cotty52/Mouse/Documents/nrf-documents/nRF52840-QFAA Reference Layout 1_0/Bill of Materials/nrf52840_qfaa_bom.xls

Bill of material
Device: | nRF52840-QFAA
Title: | Reference Layout
Version: | 1.0
Designator | Value | Description | Assembly | Footprint Doc
C1, C2, C16, C17 | 12pF | Capacitor, NP0, ±2% |  | 0201
C3 | 1.0pF | Capacitor, NP0, ±10% |  | 0201
C4 | 1.2pF | Capacitor, NP0, ±10% |  | 0201
C5, C6, C7, C8, C12 | 100nF | Capacitor, X5R, ±10% |  | 0201
C10 | N.C. | Not mounted | Not mounted | 0201
C11 | 100pF | Capacitor, NP0, ±5% |  | 0201
C13, C14 | 1.0µF | Capacitor, X5R, ±10% |  | 0402
C15 | 47nF | Capacitor, X5R, ±10% |  | 0201
L1 | 4.7nH | High frequency chip inductor ±5% |  | 0201
L2 | 2.2nH | High frequency chip inductor ±5% |  | 0201
L3 | 10µH | Chip inductor, IDC,min = 50 mA, ±20% |  | 0603
L4 | 15nH | High frequency chip inductor ±10% |  | 0402
U1 | nRF52840-QFAA | Multi-protocol Bluetooth Low Energy, IEEE 802.15.4, ANT and 2.4GHz proprietary system-on-chip |  | QFN-48
X1 | 32MHz | XTAL SMD 2016, 32MHz, Cl=8pF, Total Tol: ±30ppm |  | XTAL_2016
X2 | 32.768kHz | XTAL SMD 2012, 32.768kHz, Cl=9pF, Total Tol: ±50ppm |  | XTAL_2012
