cotty52/Mouse/KiCad/bom/Mouse_Project-BOM-2026-01-19.xlsx

 | Sourced | Placed | References | Value | Footprint | Quantity
1 | TRUE | FALSE | C1, C6, C9, C11 | 10uF | CL31A106KBHNNNE | 4
2 | TRUE | FALSE | C3, C4, C5, C8 | 0.1uF | C1206C104K5RACTU | 4
3 | TRUE | FALSE | C2, C7 | 4.7uF | CL31B475KBHNNNE | 2
4 | TRUE | FALSE | C10 | 120pF | C0805C121J5GACTU | 1
5 | TRUE | FALSE | R1 | 10k | RC1206FR-0710KL | 1
6 | TRUE | TRUE | R2 | 13 | RC0805N_YAG | 1
7 | TRUE | TRUE | R5 | 330k | RES_CRGCQ1206F330K_TEC | 1
8 | TRUE | FALSE | L1 | 470nH | DFE252012P-1R0M=P2 | 1
9 | TRUE | TRUE | U1 | TPS62821DLCR | TPS62821DLCR | 1
10 | TRUE | FALSE | U2 | TTC_Gold_Encoder | TTC_Gold_Encoder | 1
11 | TRUE | FALSE | SW1 | Power | SW_1218_EWI | 1
12 | TRUE | FALSE | SW2 | Signal | SW_1218_EWI | 1
13 | TRUE | FALSE | SW3 | Scroll_Button | SW4_1825910-B_TEC | 1
14 | TRUE | FALSE | SW4 | DPI_Button | SW4_1825910-B_TEC | 1
15 | TRUE | FALSE | Kailh_Switch1 | Left | Kailh_Switch | 1
16 | TRUE | FALSE | Kailh_Switch2 | Right | Kailh_Switch | 1
17 | TRUE | FALSE | Kailh_Switch3 | Thumb1 | Kailh_Switch | 1
18 | TRUE | FALSE | Kailh_Switch4 | Thumb2 | Kailh_Switch | 1
19 | TRUE | FALSE | NRF52840_ProMicro1 | nrf52840 | nrf52840_promicro | 1
20 | TRUE | FALSE | PMW3389DM-T3QU1 | pmw3389 | pmw3389dm-t3qu | 1
21 | TRUE | FALSE | J1 | B2B-PH-K-S | CONN2_B2B-PH-K-S_JST | 1
