cotty52/Mouse/Documents/nrf-Dongle.3mf

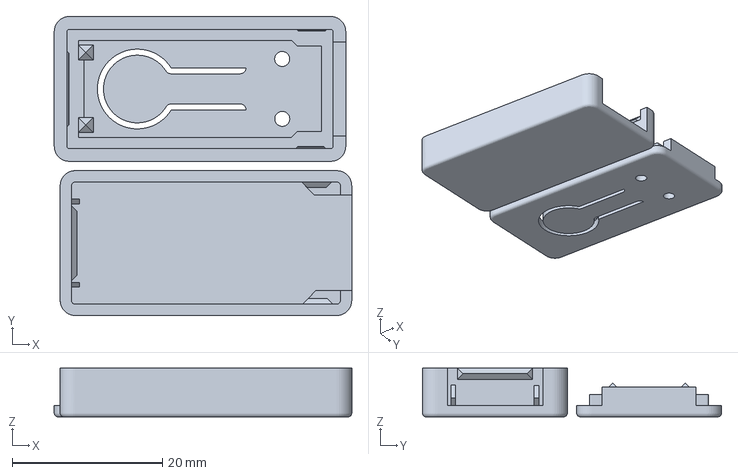
[picture p1: CAD file, 2026-04-07]
Documents/nrf-Dongle.3mf
39.5 x 39.7 x 6.50 mm
