cotty52/Mouse/KiCad/Mouse_Project_Libraries/GRM022R71A121KA01L.step

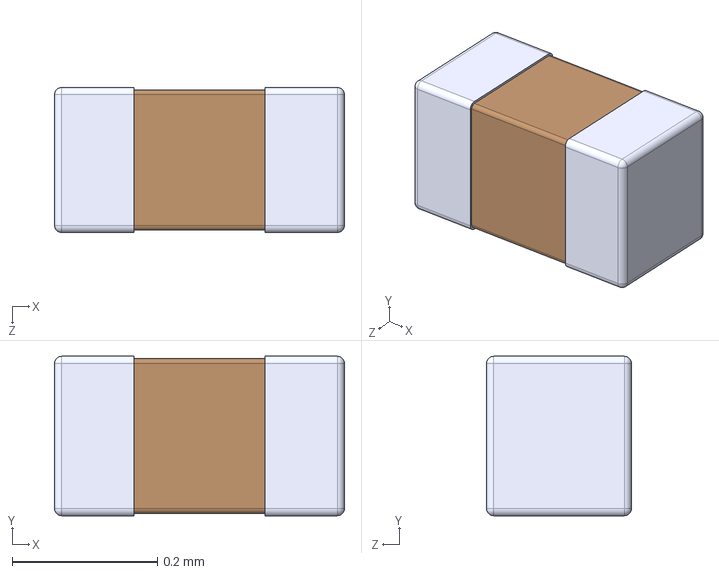
[picture p2: CAD file, 2025-11-20]
KiCad/Mouse_Project_Libraries/GRM022R71A121KA01L.step
0.4 x 0.22 x 0.2 mm
