cotty52/Mouse/KiCad/Mouse_Project_Libraries/CL31A106KBHNNNE.step

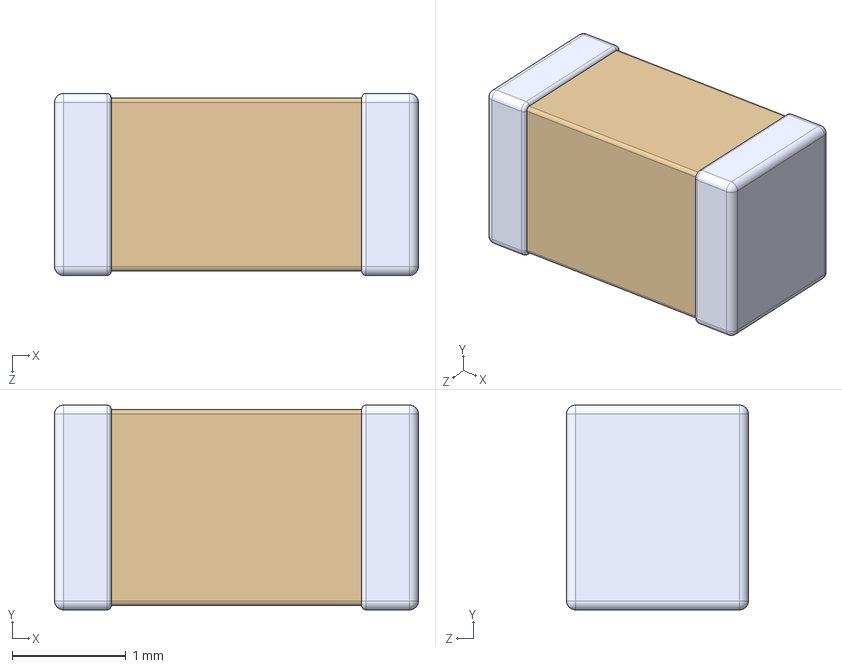
[picture p3: CAD file, 2025-11-20]
KiCad/Mouse_Project_Libraries/CL31A106KBHNNNE.step
3.20 x 1.80 x 1.60 mm
