cotty52/Mouse/KiCad/Mouse_Project_Libraries/C1206C104K5RACTU.step

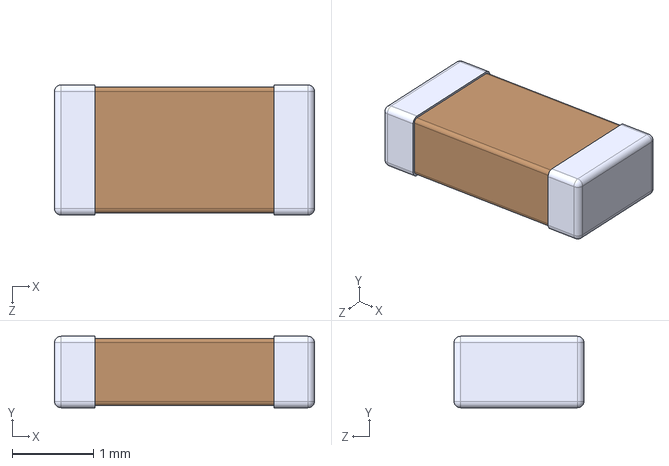
[picture p4: CAD file, 2025-11-20]
KiCad/Mouse_Project_Libraries/C1206C104K5RACTU.step
3.20 x 0.88 x 1.60 mm
