cotty52/Mouse/KiCad/Mouse_Project_Libraries/C0805C121J5GACTU.STEP

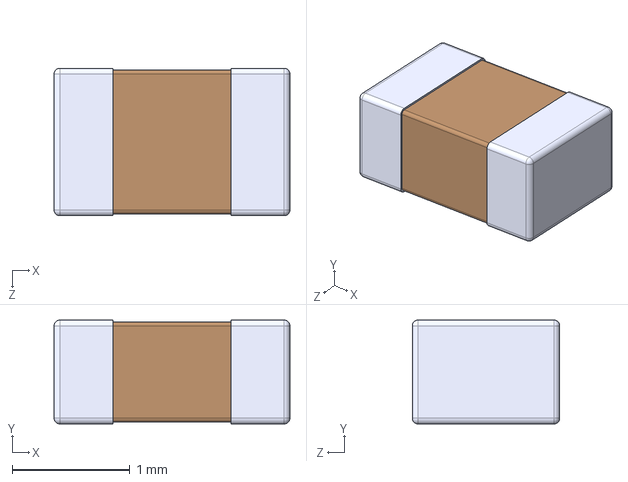
[picture p5: CAD file, 2025-11-20]
KiCad/Mouse_Project_Libraries/C0805C121J5GACTU.STEP
2.00 x 0.88 x 1.25 mm
