cotty52/Mouse/KiCad/Mouse_Project_Libraries/RC1206FR-0710KL.step

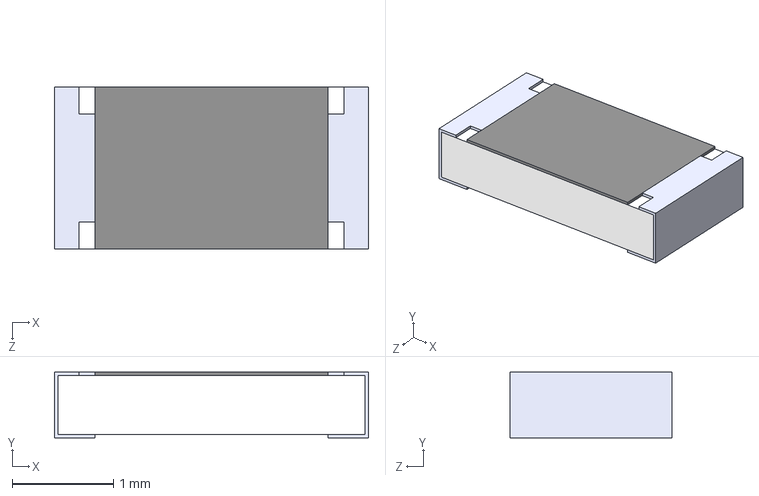
[picture p6: CAD file, 2025-11-20]
KiCad/Mouse_Project_Libraries/RC1206FR-0710KL.step
3.10 x 0.65 x 1.60 mm
