cotty52/Mouse/KiCad/Mouse_Project_Libraries/CRGCQ1206F330K.step

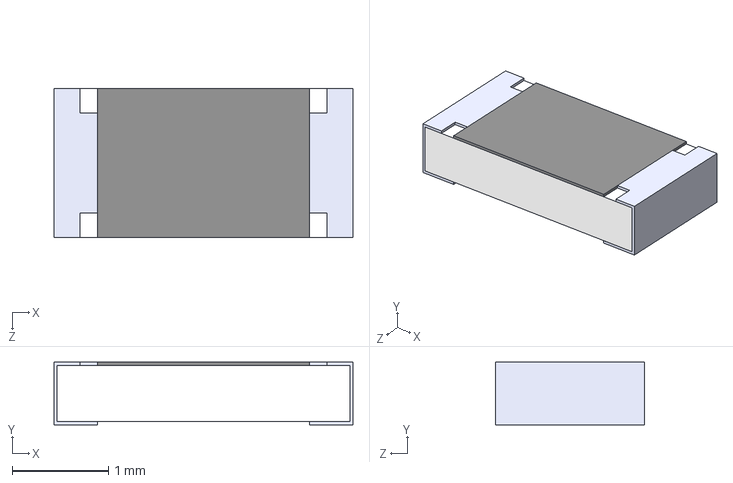
[picture p7: CAD file, 2025-03-05]
KiCad/Mouse_Project_Libraries/CRGCQ1206F330K.step
3.10 x 0.65 x 1.55 mm
