cotty52/Mouse/KiCad/Mouse_Project_Libraries/RC0402FR-07100KL.step

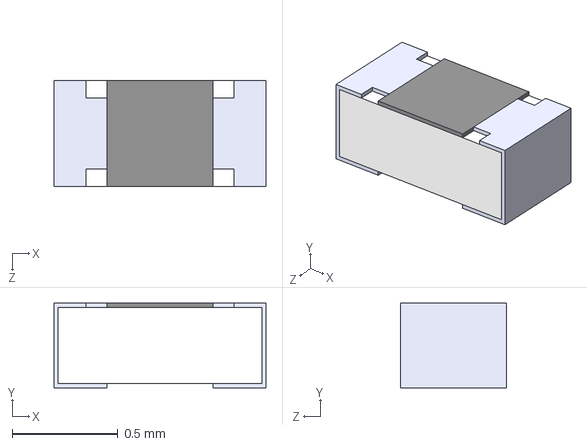
[picture p8: CAD file, 2025-03-01]
KiCad/Mouse_Project_Libraries/RC0402FR-07100KL.step
1 x 0.4 x 0.5 mm
