cotty52/Mouse/KiCad/Mouse_Project_Libraries/RES_CIGT201610.step

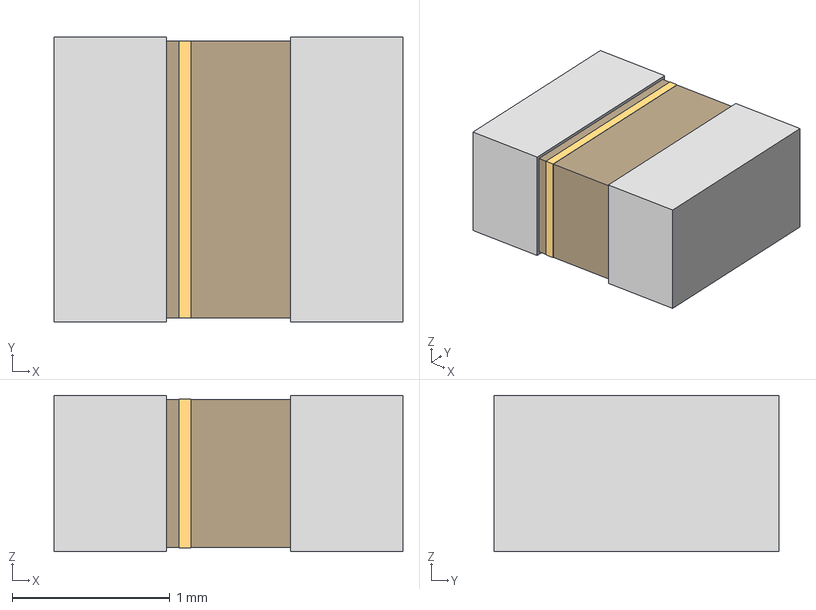
[picture p9: CAD file, 2025-03-01]
KiCad/Mouse_Project_Libraries/RES_CIGT201610.step
2.21 x 1.80 x 0.991 mm
