cotty52/Mouse/KiCad/Mouse_Project_Libraries/CL10B104KB8NNNC.step

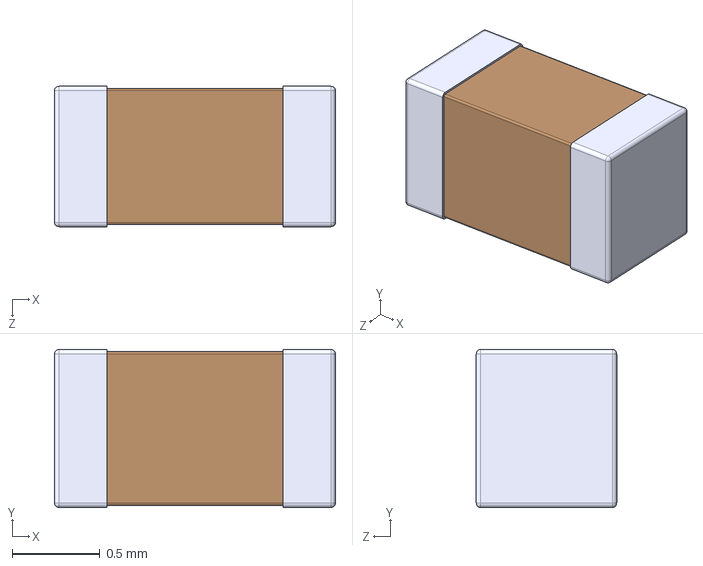
[picture p10: CAD file, 2025-03-01]
KiCad/Mouse_Project_Libraries/CL10B104KB8NNNC.step
1.60 x 0.9 x 0.8 mm
