cotty52/Mouse/KiCad/Mouse_Project_Libraries/RMCF0603FT220K.step

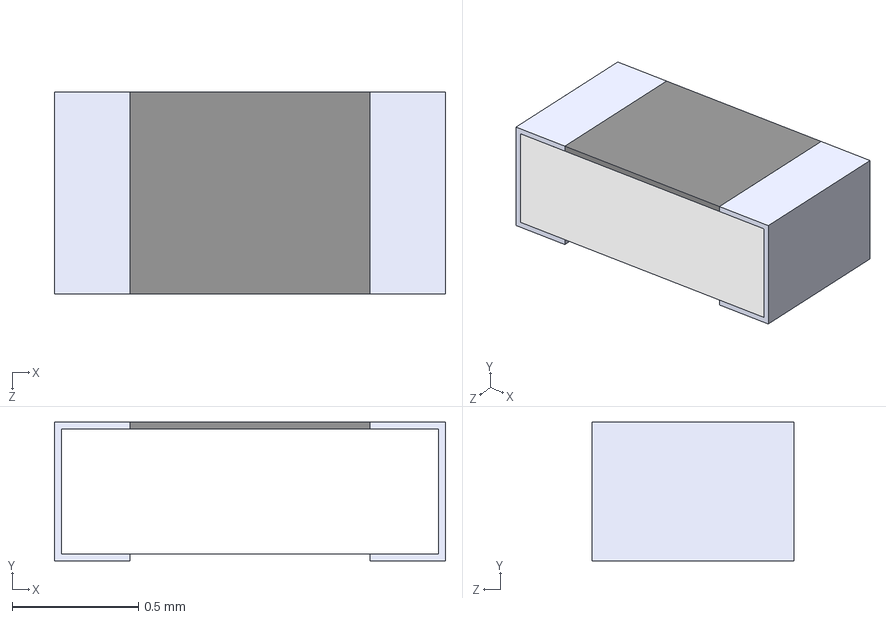
[picture p11: CAD file, 2025-03-01]
KiCad/Mouse_Project_Libraries/RMCF0603FT220K.step
1.55 x 0.55 x 0.8 mm
