cotty52/Mouse/KiCad/Mouse_Project_Libraries/GRM0335C1H121JA01D.step

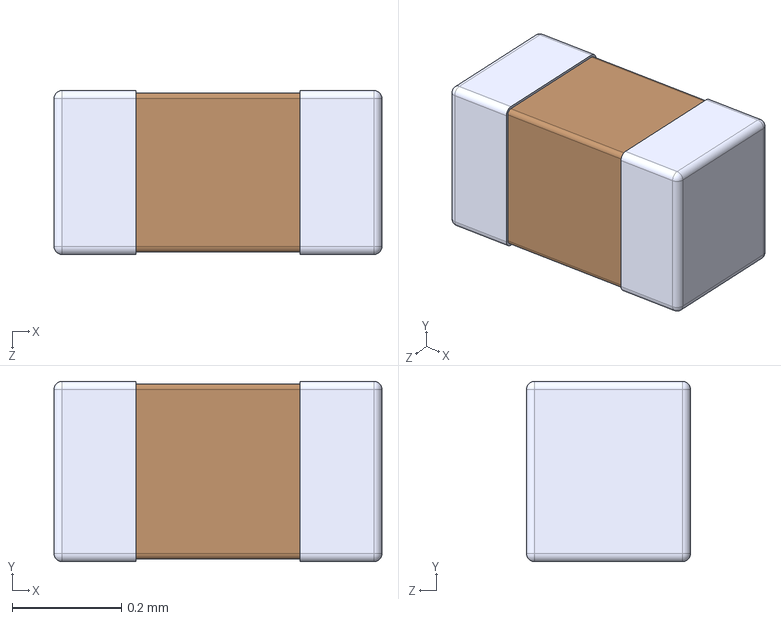
[picture p12: CAD file, 2025-03-01]
KiCad/Mouse_Project_Libraries/GRM0335C1H121JA01D.step
0.6 x 0.33 x 0.3 mm
