cotty52/Mouse/KiCad/Mouse_Project_Libraries/CL21A106KOQNNNE.step

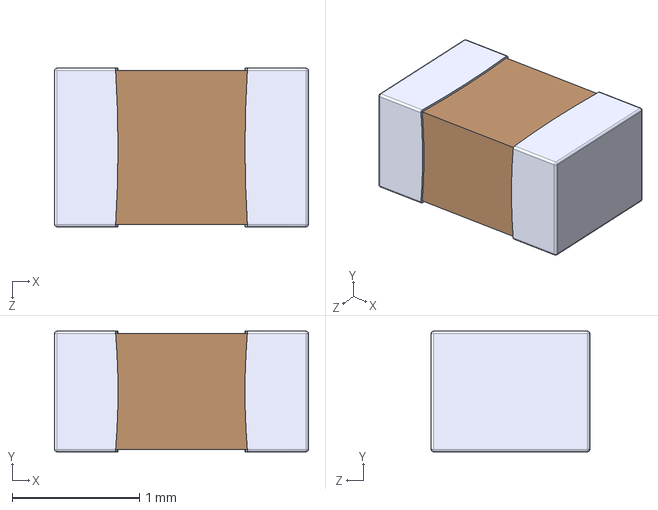
[picture p13: CAD file, 2025-03-01]
KiCad/Mouse_Project_Libraries/CL21A106KOQNNNE.step
2.00 x 0.95 x 1.25 mm
