cotty52/Mouse/KiCad/Mouse_Project_Libraries/RC0805FR-0713RL.step

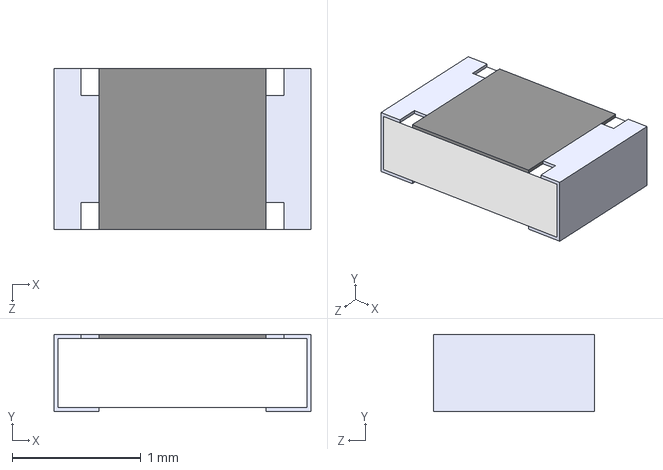
[picture p14: CAD file, 2025-03-01]
KiCad/Mouse_Project_Libraries/RC0805FR-0713RL.step
2.00 x 0.6 x 1.25 mm
