cotty52/Mouse/KiCad/Mouse_Project_Libraries/EG1218.stp

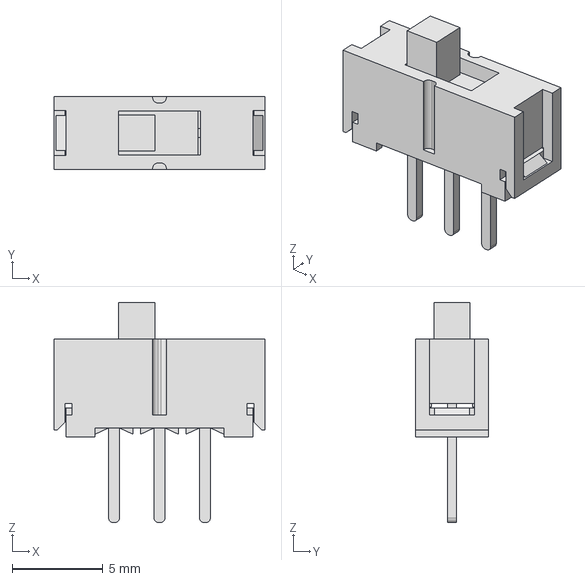
[picture p15: CAD file, 2025-03-01]
KiCad/Mouse_Project_Libraries/EG1218.stp
11.6 x 4.00 x 12.1 mm
