cotty52/Mouse/KiCad/Mouse_Project_Libraries/CL-SB-13B-01T.stp

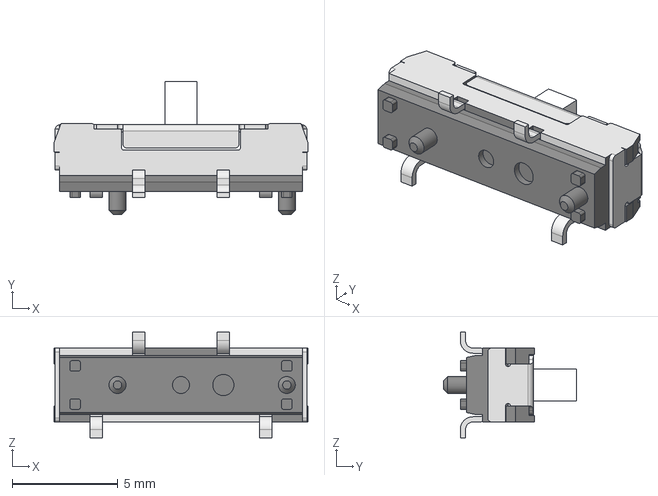
[picture p16: CAD file, 2025-03-01]
KiCad/Mouse_Project_Libraries/CL-SB-13B-01T.stp
12.0 x 6.30 x 5.00 mm
13B-01_c
3Top setting_s
