cotty52/Mouse/KiCad/Mouse_Project_Libraries/B2B-PH-K-S.step

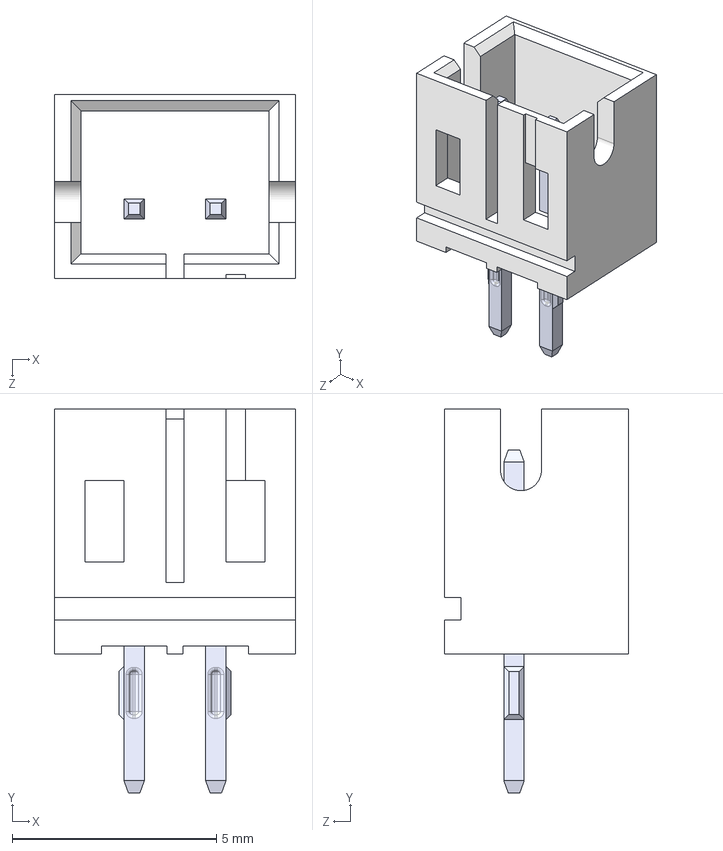
[picture p17: CAD file, 2025-02-25]
KiCad/Mouse_Project_Libraries/B2B-PH-K-S.step
5.90 x 9.40 x 4.50 mm
