cotty52/Mouse/(list of files, cad)

Other CAD files:
KiCad/Mouse_Project_Libraries/1825910-6.step
KiCad/Mouse_Project_Libraries/DFE252012P-R47M_P2.step
KiCad/Mouse_Project_Libraries/TPS62821DLCR.step
KiCad/Mouse_Project_Libraries/nrf52840.stp
