cotty52/Mouse/(list of files, drawings)

Other design files:
Documents/nrf-documents/nRF52840-QFAA Reference Layout 1_0/Altium Designer files/nrf52840_qfaa.PcbDoc
Documents/nrf-documents/nRF52840-QFAA Reference Layout 1_0/Altium Designer files/nrf52840_qfaa.PrjPCB
Documents/nrf-documents/nRF52840-QFAA Reference Layout 1_0/Altium Designer files/nrf52840_qfaa.SchDoc
