cotty52/Mouse/KiCad/Mouse_Project.kicad_pcb

## KiCad design KiCad/Mouse_Project.kicad_pcb (2026-01-30)

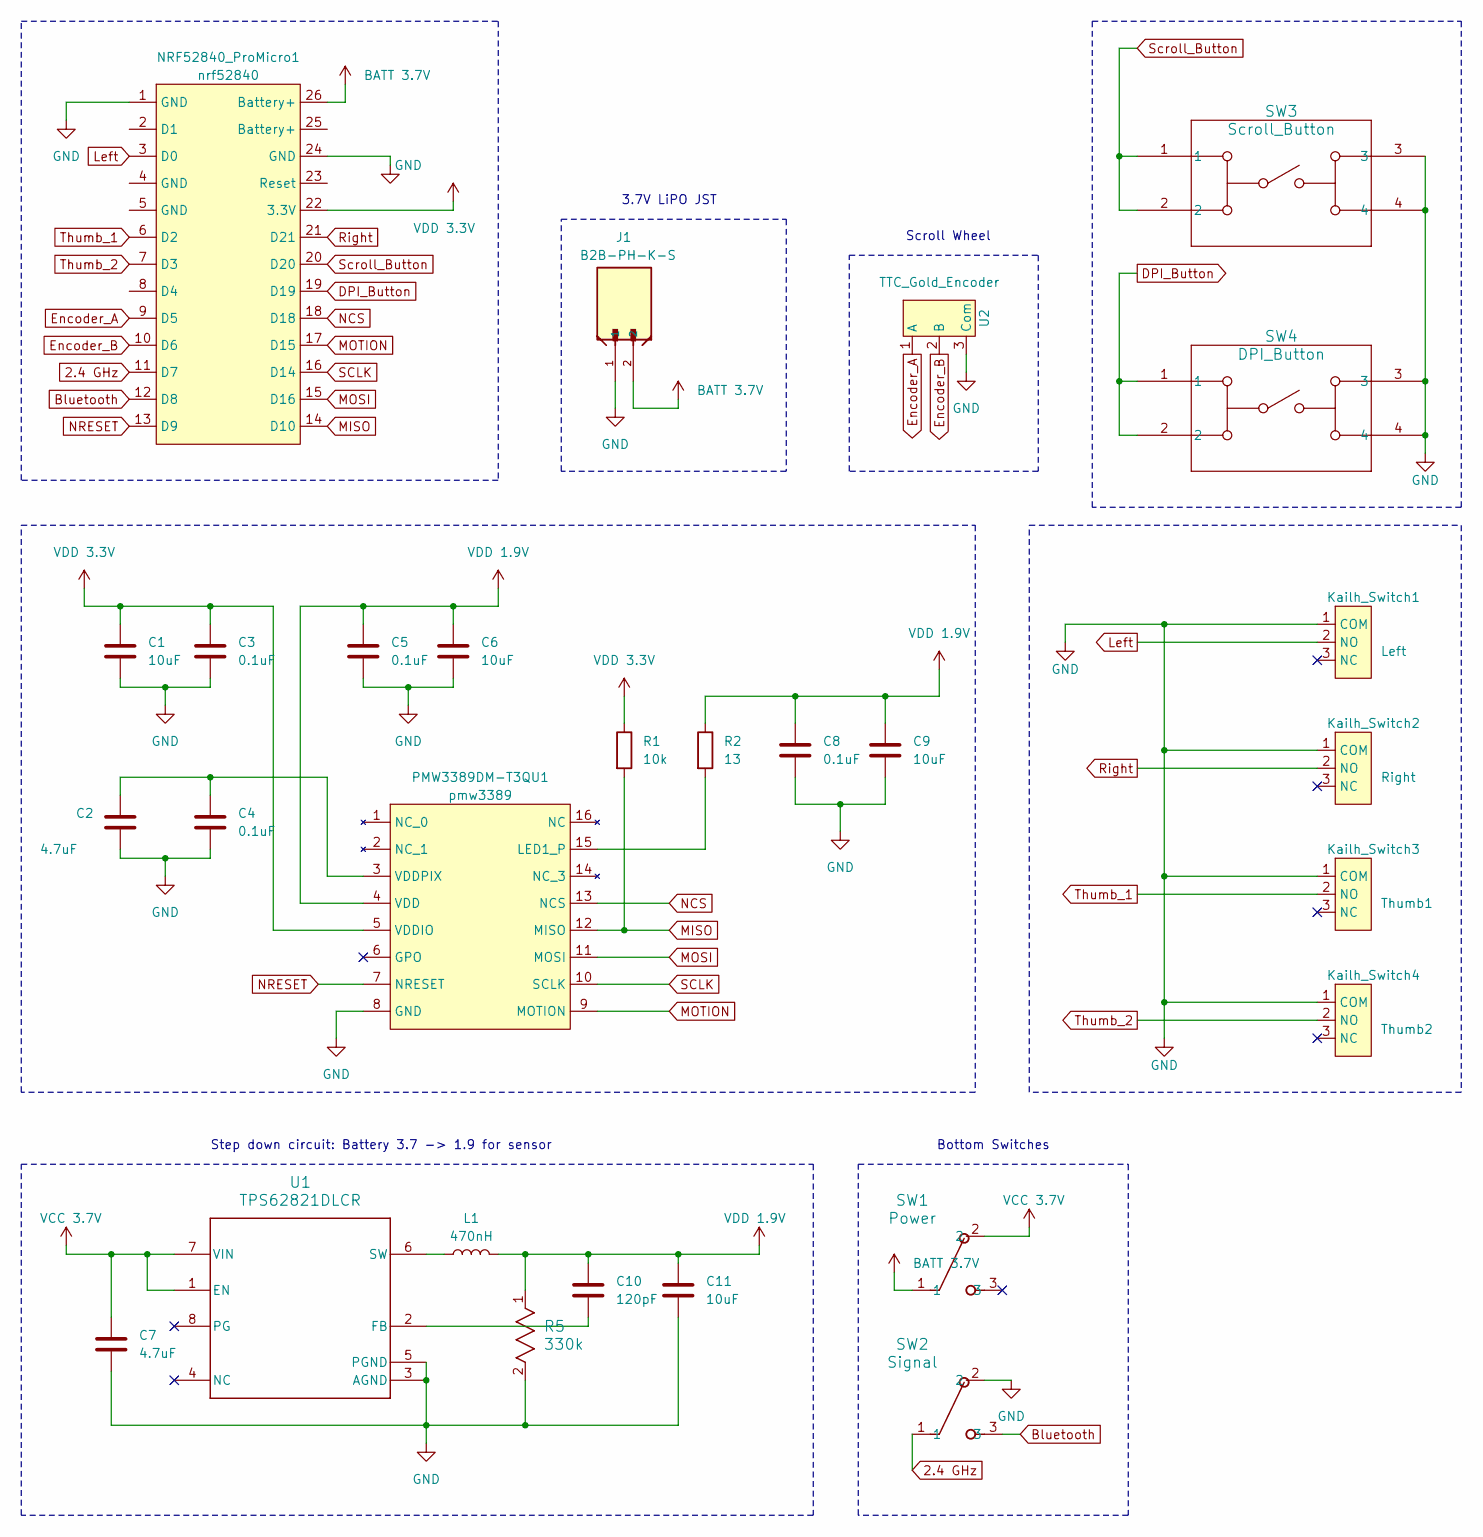
[picture p18: schematic Mouse_Project.kicad_sch]

Parts:
C1, C6, C9, C11: 10uF; CL31A106KBHNNNE
C2, C7: 4.7uF; CL31B475KBHNNNE
C3, C4, C5, C8: 0.1uF; C1206C104K5RACTU
C10: 120pF; C0805C121J5GACTU
J1: B2B-PH-K-S; CONN2_B2B-PH-K-S_JST
Kailh_Switch1: Left; Kailh_Switch
Kailh_Switch2: Right; Kailh_Switch
Kailh_Switch3: Thumb1; Kailh_Switch
Kailh_Switch4: Thumb2; Kailh_Switch
L1: 470nH; DFE252012P-1R0M=P2
NRF52840_ProMicro1: nrf52840; nrf52840_promicro
PMW3389DM-T3QU1: pmw3389; pmw3389dm-t3qu
R1: 10k; RC1206FR-0710KL
R2: 13; RC0805N_YAG
R5: 330k; RES_CRGCQ1206F330K_TEC
SW1: Power; SW_1218_EWI
SW2: Signal; SW_1218_EWI
SW3: Scroll_Button; SW4_1825910-B_TEC
SW4: DPI_Button; SW4_1825910-B_TEC
U1: TPS62821DLCR
U2: TTC_Gold_Encoder

Connections:
2.4 GHz: NRF52840_ProMicro1.11 (D7), SW2.1
BATT 3.7V: J1.2, NRF52840_ProMicro1.26 (Battery+), SW1.1
Bluetooth: NRF52840_ProMicro1.12 (D8), SW2.3
DPI_Button: NRF52840_ProMicro1.19 (D19), SW4.1, SW4.2
Encoder_A: NRF52840_ProMicro1.9 (D5), U2.1 (A)
Encoder_B: NRF52840_ProMicro1.10 (D6), U2.2 (B)
GND: C1.2, C2.2, C3.2, C4.2, C5.2, C6.2, C7.2, C8.2, C9.2, C11.2, J1.1, Kailh_Switch1.1 (COM), Kailh_Switch2.1 (COM), Kailh_Switch3.1 (COM), Kailh_Switch4.1 (COM), NRF52840_ProMicro1.1 (GND), NRF52840_ProMicro1.24 (GND), PMW3389DM-T3QU1.8 (GND), R5.2, SW2.2, SW3.3, SW3.4, SW4.3, SW4.4, U1.3 (AGND), U1.5 (PGND), U2.3 (Com)
Left: Kailh_Switch1.2 (NO), NRF52840_ProMicro1.3 (D0)
MISO: NRF52840_ProMicro1.14 (D10), PMW3389DM-T3QU1.12 (MISO), R1.2
MOSI: NRF52840_ProMicro1.15 (D16), PMW3389DM-T3QU1.11 (MOSI)
MOTION: NRF52840_ProMicro1.17 (D15), PMW3389DM-T3QU1.9 (MOTION)
NCS: NRF52840_ProMicro1.18 (D18), PMW3389DM-T3QU1.13 (NCS)
NRESET: NRF52840_ProMicro1.13 (D9), PMW3389DM-T3QU1.7 (NRESET)
unnamed: PMW3389DM-T3QU1.15 (LED1_P), R2.2
unnamed: C2.1, C4.1, PMW3389DM-T3QU1.3 (VDDPIX)
unnamed: C10.2, U1.2 (FB)
unnamed: L1.1, U1.6 (SW)
Right: Kailh_Switch2.2 (NO), NRF52840_ProMicro1.21 (D21)
SCLK: NRF52840_ProMicro1.16 (D14), PMW3389DM-T3QU1.10 (SCLK)
Scroll_Button: NRF52840_ProMicro1.20 (D20), SW3.1, SW3.2
Thumb_1: Kailh_Switch3.2 (NO), NRF52840_ProMicro1.6 (D2)
Thumb_2: Kailh_Switch4.2 (NO), NRF52840_ProMicro1.7 (D3)
VCC 3.7V: C7.1, SW1.2, U1.1 (EN), U1.7 (VIN)
VDD 1.9V: C5.1, C6.1, C8.1, C9.1, C10.1, C11.1, L1.2, PMW3389DM-T3QU1.4 (VDD), R2.1, R5.1
VDD 3.3V: C1.1, C3.1, NRF52840_ProMicro1.22 (3.3V), PMW3389DM-T3QU1.5 (VDDIO), R1.1

Notes on the sheet:
Step down circuit: Battery 3.7 -> 1.9 for sensor
Scroll Wheel
Bottom Switches
3.7V LiPO JST

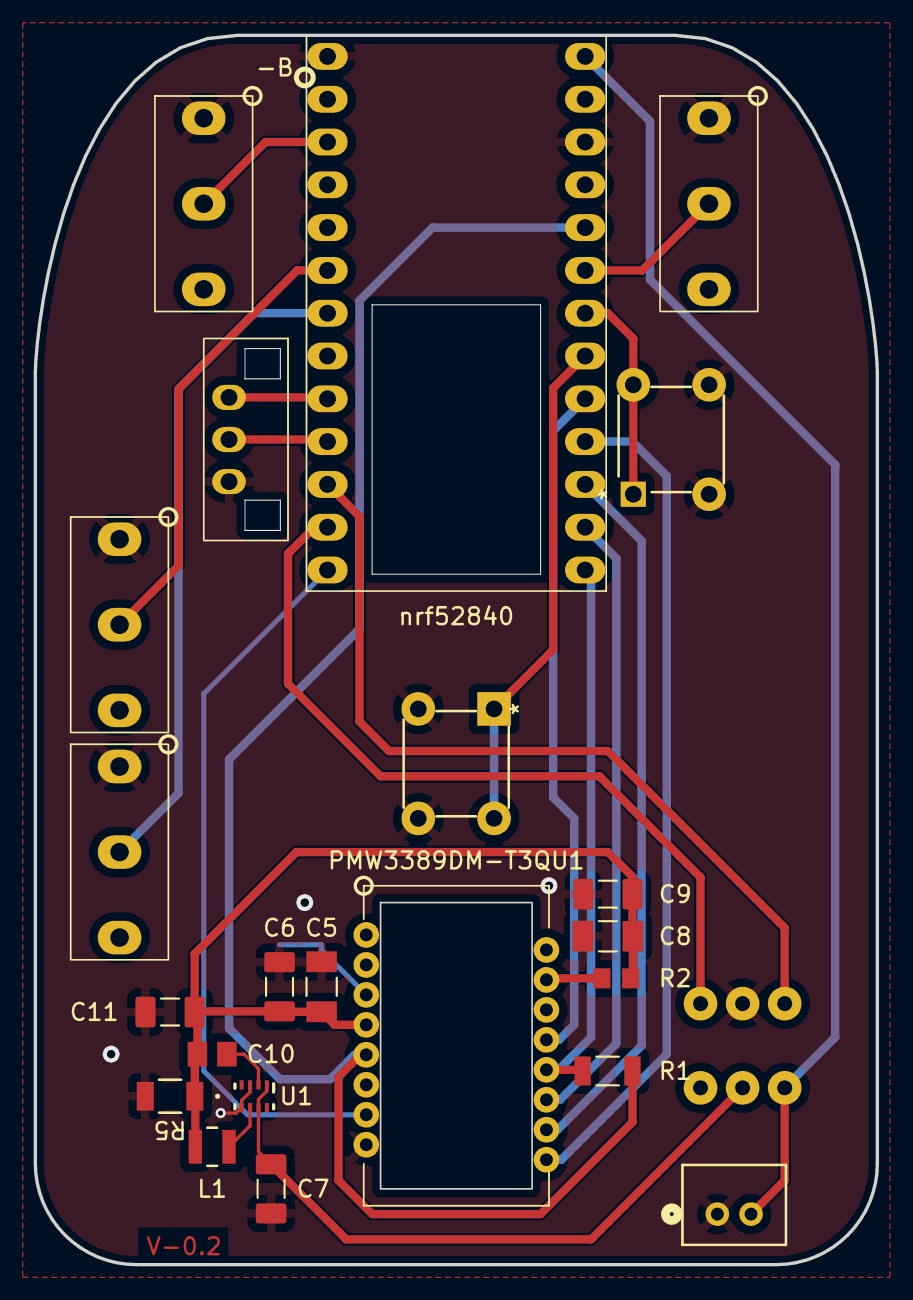
[picture p19: board Mouse_Project.kicad_pcb from above]

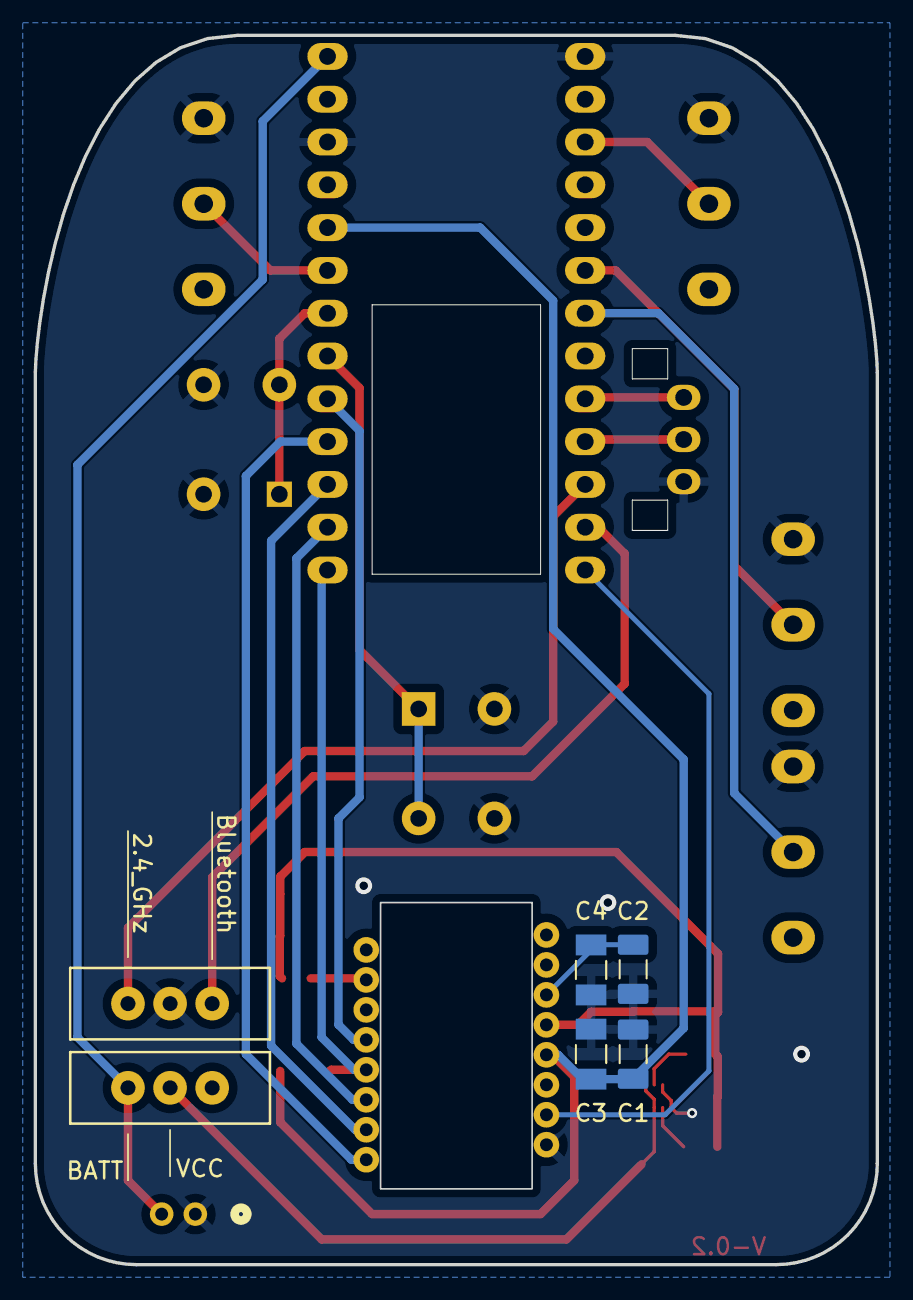
[picture p20: board Mouse_Project.kicad_pcb from below]

Board: 2 copper layers, 50.0 x 73.0 mm, 28 parts (6 on the bottom side), 25 nets.
