cotty52/Mouse/Documents/nrf-documents/nRF52840-QFAA Reference Layout 1_0/Altium Designer files/nrf52840_qfaa/nrf52840_qfaa.kicad_pcb

## KiCad design Documents/nrf-documents/nRF52840-QFAA Reference Layout 1_0/Altium Designer files/nrf52840_qfaa/nrf52840_qfaa.kicad_pcb (2026-04-21)

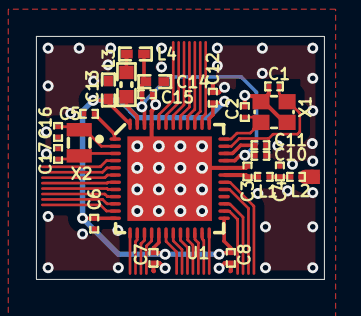
[picture p23: board nrf52840_qfaa.kicad_pcb from above]

Board: 2 copper layers, 16.0 x 13.5 mm, 23 parts (0 on the bottom side), 13 nets.

Parts:
C1, C2, C16, C17: 12pF; CAPC0603X03L_C
C3: 1.0pF; CAPC0603X03L_C
C4: 1.2pF; CAPC0603X03L_C
C5, C6, C7, C8, C12: 100nF; CAPC0603X03L_C
C10: N.C.; CAPC0603X03L_C_NC
C11: 100pF; CAPC0603X03L_C
C13, C14: 1.0µF; CAPC1005X04L
C15: 47nF; CAPC0603X03L_C
L1: 4.7nH; INDC0603X03L_C
L2: 2.2nH; INDC0603X03L_C
L3: 10µH; INDC1608X06L
L4: 15nH; INDC1005X04L
U1: nRF52840-QFAA; QFN40P600X600X90-48N
X1: 32MHz; XTAL_2016_NT
X2: 32.768kHz; XTAL_2012

Connections:
DEC1: C5.1, U1.1
DEC3: C11.1, U1.34
DEC4_6: C10.2, C14.2, C15.1, L4.1, U1.33, U1.46
GND: C1.2, C2.2, C3.1, C4.1, C5.2, C6.2, C7.2, C8.2, C10.1, C11.2, C12.2, C13.2, C14.1, C15.2, C16.2, C17.2, U1.32, U1.45, U1.49, X1.2
NetC3_2: C3.2, L1.1, U1.31
NetC4_2: C4.2, L1.2, L2.1
NetL3_1: L3.1, L4.2
NetL3_2: L3.2, U1.47
P0.00/XL1: C16.1, U1.2, X2.1
P0.01/XL2: C17.1, U1.3, X2.2
VDD_NRF: C6.1, C7.1, C8.1, C12.1, C13.1, U1.12, U1.17, U1.25, U1.37, U1.48
XC1: C1.1, U1.35, X1.1
XC2: C2.1, U1.36, X1.3
