cotty52/Mouse/Documents/zmk-driver-pmw3389-main/drivers/input/input_pmw3389.c

/*
 * Copyright (c) 2025 George Norton
 *
 * SPDX-License-Identifier: MIT
 */
 
#define DT_DRV_COMPAT pixart_pmw3389

#include <zephyr/kernel.h>
#include <zephyr/sys/byteorder.h>
#include <zephyr/input/input.h>
#include <zephyr/logging/log.h>
#include <zephyr/sys/util.h>
#include "input_pmw3389.h"

LOG_MODULE_REGISTER(pmw3389, CONFIG_INPUT_LOG_LEVEL);

#if defined(CONFIG_INPUT_PIXART_PMW3389_USE_OWN_THREAD)
    K_THREAD_STACK_DEFINE(pmw3389_stack, CONFIG_INPUT_PIXART_PMW3389_THREAD_STACK_SIZE);
#endif

static int pmw3389_set_interrupt(const struct device *dev, const bool en) {
    const struct pmw3389_config *config = dev->config;
    int err = gpio_pin_interrupt_configure_dt(&config->irq_gpio,
                                                en ? GPIO_INT_LEVEL_ACTIVE : GPIO_INT_DISABLE);
    if (err < 0) {
        LOG_ERR("Can't set interrupt");
    }
    return err;
}

static int pmw3389_spi_read(const struct device *dev, const uint8_t addr, uint8_t *buf, const uint8_t len, const int32_t address_wait) {
    const struct pmw3389_config *config = dev->config;
    uint8_t tx_buffer[1] = { PMW3389_SPI_READ | addr };

    // Send the address to read from
    const struct spi_buf tx_buf[1] = {
        {
        .buf = tx_buffer,
        .len = 1,
        }
    };
    const struct spi_buf_set tx = {
        .buffers = tx_buf,
        .count = 1,
    };
    
    int err = spi_write_dt(&config->spi, &tx);
    if (err < 0) {
        LOG_ERR("Error writing the SPI read-address: %d", err);
        spi_release_dt(&config->spi);
        return err;
    }

    // Wait before reading the data, having sent the address
    k_usleep(address_wait);

    // Read the data
    struct spi_buf rx_buf[1] = {
        {
        .buf = buf,
        .len = len,
        },
    };
    const struct spi_buf_set rx = {
        .buffers = rx_buf,
        .count = 1,
    };
    err = spi_read_dt(&config->spi, &rx);
    if (err != 0) {
        LOG_ERR("Error reading the SPI payload: %d", err);
        spi_release_dt(&config->spi);
        return err;
    }

    // Wait before releasing the NCS pin
    k_usleep(PMW3389_T_SCLK_NCS_READ);

    spi_release_dt(&config->spi);

    return err;
}

static int pmw3389_spi_write_reg(const struct device *dev, const uint8_t addr, const uint8_t val) {
    struct pmw3389_data *data = dev->data;
    const struct pmw3389_config *config = dev->config;

    data->motion_burst_active = false;

    // Send the address and payload, read into a dummy buffer
    uint8_t tx_buffer[2] = {PMW3389_SPI_WRITE | addr, val};
    uint8_t rx_buffer[2] = {};

    const struct spi_buf tx_buf = {
        .buf = tx_buffer,
        .len = 2,
    };
    const struct spi_buf_set tx = {
        .buffers = &tx_buf,
        .count = 1,
    };

    const struct spi_buf rx_buf = {
        .buf = rx_buffer,
        .len = 2,
    };
    const struct spi_buf_set rx = {
        .buffers = &rx_buf,
        .count = 1,
    };

    const int err = spi_transceive_dt(&config->spi, &tx, &rx);
    if (err < 0) {
        LOG_ERR("spi err: %d", err);
    }

    // Wait before releasing the NCS pin
    k_usleep(PMW3389_T_SCLK_NCS_WRITE);

    spi_release_dt(&config->spi);

    // Wait before we issue another read/write
    k_usleep(PMW3389_T_SWR);

    return err;
}

static int pmw3389_spi_read_reg(const struct device *dev, const uint8_t addr, uint8_t *val) {
    int err = 0;
    struct pmw3389_data *data = dev->data;

    data->motion_burst_active = false;

    err = pmw3389_spi_read(dev, addr, val, 1, PMW3389_T_SRAD);
    // Wait before we issue another read/write
    k_usleep(PMW3389_T_SRR);
    return err;
}

static int pmw3389_spi_read_motion_burst(const struct device *dev, uint8_t *val, const uint8_t len) {
    int err = 0;
    struct pmw3389_data *data = dev->data;

    if (!data->motion_burst_active) {
        // Write any value to the motion burst register to activate burst mode
        pmw3389_spi_write_reg(dev, PMW3389_REG_MOTION_BURST, 0);
        data->motion_burst_active = true;
    }
    err = pmw3389_spi_read(dev, PMW3389_REG_MOTION_BURST, val, len, PMW3389_T_SRAD_MOTBR);
    // We cannot wait for the required 500ns, so settle for 1us
    k_usleep(1);
    return err;
}

static void pmw3389_gpio_callback(const struct device *gpiob, struct gpio_callback *cb, uint32_t pins) {
    struct pmw3389_data *data = CONTAINER_OF(cb, struct pmw3389_data, irq_gpio_cb);
    const struct device *dev = data->dev;
    pmw3389_set_interrupt(dev, false);
#if defined(CONFIG_INPUT_PIXART_PMW3389_USE_OWN_THREAD)
    k_work_submit_to_queue(&data->driver_work_queue, &data->motion_work);
#else
    k_work_submit(&data->motion_work);
#endif
}

static int pmw3389_init_irq(const struct device *dev) {
    int err = 0;
    struct pmw3389_data *data = dev->data;
    const struct pmw3389_config *config = dev->config;

    // check readiness of irq gpio pin
    if (!device_is_ready(config->irq_gpio.port)) {
        LOG_ERR("IRQ GPIO device not ready");
        return -ENODEV;
    }

    // init the irq pin
    err = gpio_pin_configure_dt(&config->irq_gpio, GPIO_INPUT);
    if (err) {
        LOG_ERR("Cannot configure IRQ GPIO");
        return err;
    }

    // setup and add the irq callback associated
    err = gpio_pin_configure_dt(&config->irq_gpio, GPIO_INPUT);
    if (err) {
        LOG_ERR("Failed to configure IRQ pin");
    }
    gpio_init_callback(&data->irq_gpio_cb, pmw3389_gpio_callback, BIT(config->irq_gpio.pin));
    err = gpio_add_callback(config->irq_gpio.port, &data->irq_gpio_cb);
    if (err) {
        LOG_ERR("Cannot add IRQ GPIO callback");
    }

    return err;
}

static void pmw3389_read_motion_report(const struct device *dev) {
    const struct pmw3389_config *config = dev->config;
    struct motion_burst motion_report = {};
    int err = pmw3389_spi_read_motion_burst(dev, (uint8_t *) &motion_report, sizeof(motion_report));
    if ((err != 0) || (motion_report.motion == 0xff)) {
        // If burst most became deactivated for some reason, reactivate it.
        // We see this sometimes if there is a second device on the SPI bus.
        struct pmw3389_data *data = dev->data;
        data->motion_burst_active = false;
        pmw3389_spi_read_motion_burst(dev, (uint8_t *) &motion_report, sizeof(motion_report));
    }

    if (motion_report.motion & PMW3389_MOTION_MOT) {
        int16_t dx = (motion_report.delta_x_h << 8) | motion_report.delta_x_l;
        if (config->invert_x) {
            dx = -dx;
        }
        input_report_rel(dev, INPUT_REL_X, dx, false, K_FOREVER);
        int16_t dy = (motion_report.delta_y_h << 8) | motion_report.delta_y_l;
        if (config->invert_y) {
            dy = -dy;
        }
        input_report_rel(dev, INPUT_REL_Y, dy, true, K_FOREVER);
    }
}

static void pmw3389_work_callback(struct k_work *work) {
    struct pmw3389_data *data = CONTAINER_OF(work, struct pmw3389_data, motion_work);
    const struct device *dev = data->dev;
    pmw3389_read_motion_report(dev);

    if (data->polling_mode) {
        const struct pmw3389_config *config = dev->config;
        struct k_work_delayable *dwork = k_work_delayable_from_work(work);
        uint32_t current_cycles = k_cycle_get_32();
        uint32_t cycles_diff = current_cycles - data->last_poll_cycles;
        uint32_t delay = config->polling_interval - CLAMP(k_cyc_to_us_floor32(cycles_diff), 0, config->polling_interval);

        data->last_poll_cycles = current_cycles;
#if defined(CONFIG_INPUT_PIXART_PMW3389_USE_OWN_THREAD)
        k_work_reschedule_for_queue(&data->driver_work_queue, dwork, K_USEC(delay));
#else
        k_work_reschedule(dwork, K_USEC(delay));
#endif
    }
    else {
        pmw3389_set_interrupt(dev, true);
    }
}

static void pmw3389_async_init(struct k_work *work) {
    struct k_work_delayable *work_delayable = (struct k_work_delayable *)work;
    struct pmw3389_data *data = CONTAINER_OF(work_delayable, struct pmw3389_data, init_work);
    const struct device *dev = data->dev;
    const struct pmw3389_config *config = dev->config;


#if defined(CONFIG_INPUT_PIXART_PMW3389_USE_OWN_THREAD)
    k_work_queue_init(&data->driver_work_queue);

    k_work_queue_start(&data->driver_work_queue, pmw3389_stack,
                       K_THREAD_STACK_SIZEOF(pmw3389_stack),
                       CONFIG_INPUT_PIXART_PMW3389_THREAD_PRIORITY,
                       NULL);
#endif
    k_work_init(&data->motion_work, pmw3389_work_callback);
    if(pmw3389_init_irq(dev) < 0) {
        LOG_INF("Starting in polling mode.");
        data->polling_mode = true;
    }

    // Power up sequence.
    // Step 2: drive the NCS high, then low to reset the SPI port.
    gpio_pin_set_dt(&config->cs_gpio, GPIO_OUTPUT_ACTIVE);
    k_msleep(40); 
    gpio_pin_set_dt(&config->cs_gpio, GPIO_OUTPUT_INACTIVE);

    // Step 3: write 0x5A to the Power_Up_Reset register
    pmw3389_spi_write_reg(dev, PMW3389_REG_POWER_UP, 0x5A);

    // Step 4: wait for at least 50ms
    k_msleep(50); 

    // Step 5: read the registers 2, 3, 4, 5 and 6
    for (int r=2; r<=6; r++) {
        uint8_t value = 0;
        pmw3389_spi_read_reg(dev, r, &value);
    }

    // Step 6: download the SROM. We will skip this.
    // Step 7: configure the sensor.

    // Log the sensor product and revision ID. We expect 0x42, 0x01
    uint8_t product_id = 0;
    int r1 = pmw3389_spi_read_reg(dev, PMW3389_REG_PRODUCT_ID, &product_id);

    uint8_t revision_id = 0;
    int r2 = pmw3389_spi_read_reg(dev, PMW3389_REG_REVISION_ID, &revision_id);

    LOG_INF("pmw3389 product 0x%02x (%d), revision 0x%02x (%d)", product_id, r1, revision_id, r2);

    k_mutex_lock(&data->mutex, K_FOREVER);

    // Configure the sensor orientation
    if (config->rotate_90) {
        if (config->rotate_180 || config->rotate_270) {
            LOG_ERR("Multiple rotations specified, configuring 90 degrees.");
        }
        pmw3389_spi_write_reg(dev, PMW3389_REG_CONTROL, PMW3389_CONTROL_ROTATE_90);
    }
    else if (config->rotate_180) {
        if (config->rotate_270) {
            LOG_ERR("Multiple rotations specified, configuring 180 degrees.");
  
        }
        pmw3389_spi_write_reg(dev, PMW3389_REG_CONTROL, PMW3389_CONTROL_ROTATE_180);
    }
    else if (config->rotate_270) {
        pmw3389_spi_write_reg(dev, PMW3389_REG_CONTROL, PMW3389_CONTROL_ROTATE_270);
    }

    // Configure the CPI, this may have been overriden by a call to set_attr
    uint16_t cpi = data->cpi ? data->cpi : config->cpi;
    uint16_t cpi_val = CLAMP((cpi / 50), 1, 320) - 1;
    
    LOG_INF("Setting CPI to %d (register value: 0x%04x)", cpi, cpi_val);
    pmw3389_spi_write_reg(dev, PMW3389_REG_RESOLUTION_H, (cpi_val >> 8) & 0xFF);
    pmw3389_spi_write_reg(dev, PMW3389_REG_RESOLUTION_L, cpi_val & 0xFF);

    // We always enable rest mode to save a bit of power, but probably this is a
    // wired device so it could be turned off.
    pmw3389_spi_write_reg(dev, PMW3389_REG_CONFIG_2, PWM3389_CONFIG_2_REST_EN);

    // Allow extra control over the sensor orientation
    pmw3389_spi_write_reg(dev, PMW3389_REG_ANGLE_TUNE, config->angle_tune);

    // There are only 2 allowed lift off values, 2mm and 3mm.
    if (config->lift_height_3mm) {
        pmw3389_spi_write_reg(dev, PMW3389_REG_LIFT_CONFIG, PMW3389_LIFT_CONFIG_3MM);
    }

    data->ready = true;
    k_mutex_unlock(&data->mutex);

    if (data->polling_mode) {
        struct k_work_delayable *dwork = k_work_delayable_from_work(&data->motion_work);
        data->last_poll_cycles = k_cycle_get_32();
#if defined(CONFIG_INPUT_PIXART_PMW3389_USE_OWN_THREAD)
        k_work_reschedule_for_queue(&data->driver_work_queue, dwork, K_USEC(config->polling_interval));
#else
        k_work_reschedule(dwork, K_USEC(config->polling_interval));
#endif
    }
    else {
        pmw3389_set_interrupt(dev, true);
    }

}

static int pmw3389_init(const struct device *dev) {
    struct pmw3389_data *data = dev->data;
    data->dev = dev;
    k_mutex_init(&data->mutex);

    k_work_init_delayable(&data->init_work, pmw3389_async_init);
    // How much delay do we need? K_NO_WAIT ? Some delay seems required or we dont get logging.
    k_work_schedule(&data->init_work, K_MSEC(1000));

    return 0;
}

static int pmw3389_attr_set(const struct device *dev, enum sensor_channel chan, enum sensor_attribute attr, const struct sensor_value *val) {
    struct pmw3389_data *data = dev->data;
    int err = 0;

    if (unlikely(chan != SENSOR_CHAN_ALL)) {
        return -ENOTSUP;
    }
    k_mutex_lock(&data->mutex, K_FOREVER);
    switch((int32_t) attr) {
        case PMW3389_ATTR_CPI:
            if (unlikely(!data->ready)) {
                LOG_INF("Set CPI before the device is initialized");
                // We will pickup the new cpi value during initialization.
                data->cpi = val->val1;
            }
            else {
                uint16_t cpi_val = CLAMP((val->val1 / 50), 1, 320) - 1;
                pmw3389_spi_write_reg(dev, PMW3389_REG_RESOLUTION_H, (cpi_val >> 8) & 0xFF);
                pmw3389_spi_write_reg(dev, PMW3389_REG_RESOLUTION_L, cpi_val & 0xFF);
            }
            break;
        default:
            LOG_ERR("Unknown attribute");
            err = -ENOTSUP;
    }

    k_mutex_unlock(&data->mutex);

    return err;
}

static const struct sensor_driver_api pmw3389_driver_api = {
    .attr_set = pmw3389_attr_set,
};

#define PMW3389_SPI_MODE (SPI_OP_MODE_MASTER | SPI_WORD_SET(8) | SPI_MODE_CPOL | SPI_MODE_CPHA | SPI_TRANSFER_MSB | SPI_HOLD_ON_CS | SPI_LOCK_ON)

#define PMW3389_DEFINE(n)                                                                          \
    static struct pmw3389_data data##n = {};                                                       \
    static const struct pmw3389_config config##n = {                                               \
        .spi = SPI_DT_SPEC_INST_GET(n, PMW3389_SPI_MODE, 0),                                       \
        .cs_gpio = SPI_CS_GPIOS_DT_SPEC_GET(DT_DRV_INST(n)),                                       \
        .irq_gpio = GPIO_DT_SPEC_GET_OR(DT_DRV_INST(n), irq_gpios, {}),                            \
        .cpi = DT_PROP(DT_DRV_INST(n), cpi),                                                       \
        .rotate_90 = DT_PROP(DT_DRV_INST(n), rotate_90),                                           \
        .rotate_180 = DT_PROP(DT_DRV_INST(n), rotate_180),                                         \
        .rotate_270 = DT_PROP(DT_DRV_INST(n), rotate_270),                                         \
        .angle_tune = DT_PROP(DT_DRV_INST(n), angle_tune),                                         \
        .lift_height_3mm = DT_PROP(DT_DRV_INST(n), lift_height_3mm),                               \
        .polling_interval = DT_PROP(DT_DRV_INST(n), polling_interval),                             \
        .invert_x = DT_PROP(DT_DRV_INST(n), invert_x),                                             \
        .invert_y = DT_PROP(DT_DRV_INST(n), invert_y),                                             \
    };                                                                                             \
    DEVICE_DT_INST_DEFINE(n, pmw3389_init, NULL, &data##n, &config##n, POST_KERNEL,                \
        CONFIG_INPUT_INIT_PRIORITY, &pmw3389_driver_api);

DT_INST_FOREACH_STATUS_OKAY(PMW3389_DEFINE)
