cotty52/Mouse/(commit log)

2025-02-19 updated stuff
    [Mouse_Project.kicad_pcb, Mouse_Project.kicad_sch, nrfmicro.kicad_pcb, nrfmicro.kicad_sch]
2025-03-01 Almost done
    [1825910-6.step, CL-SB-13B-01T.stp, CL10A475KP8NNNC.step, CL10B104KB8NNNC.step, CL21A106KOQNNNE.step, EG1218.stp, GRM0335C1H121JA01D.step, Mouse_Project.kicad_pcb]
2025-03-05 Completed version 0.1
    [BOM.csv, CRGCQ1206F330K.step, Mouse_Project.kicad_pcb, Mouse_Project.kicad_sch, freerouting.dsn, temp-freerouting.dsn]
2025-11-13 Lots of edits. Partial reorganizing.
    [default_4MB.csv]
2025-11-14 A little organization
    [default_4MB.csv]
2025-11-15 potentially working
    [Kconfig.hal, Zephyr.tsv, adc-controller.yaml, adi,max32-flash-controller.yaml, akizuki-m-02990.cfg, altera-usb-blaster2-cyclonev.cfg, ambiq,flash-controller.yaml, ambiq,mspi-controller.yaml]
2025-11-20 PCB v0.2 almost done
    [C0805C121J5GACTU.STEP, C1206C104K5RACTU.step, CL31A106KBHNNNE.step, CL31B475KBHNNNE.step, DFE252012P-R47M_P2.step, GRM022R71A121KA01L.step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]
2026-01-30 Completed v0.2
    Ordered new PCB and components
    [Mouse_Project-BOM-2026-01-19.xlsx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]
2026-04-07 upload 2026-04-07
    [nrf-Dongle.3mf]
2026-04-21 Upload 2026-04-21. Added untracked work and some documentation files.
    [BOM.csv, Kconfig.hal, Zephyr.tsv, adc-controller.yaml, adi,max32-flash-controller.yaml, akizuki-m-02990.cfg, altera-usb-blaster2-cyclonev.cfg, ambiq,flash-controller.yaml]
2026-04-27 Everything works with the nordic dongle. Bluetooth, mouse buttons, sensor.
2026-04-30 Upload 2026-04-30 added PCB images to README
