cotty52/Mouse/(notices)

Notices in the files:
KiCad/Mouse_Project_Libraries/CL-SB-13B-01T.stp:
author */ ('License CC BY-ND 4.0'),
